gitKinsey/Operation-SafeFlight/development code/preparations/Module Tests/multiple Hc-sro4 with newPing/versuchsaufbau.jpg

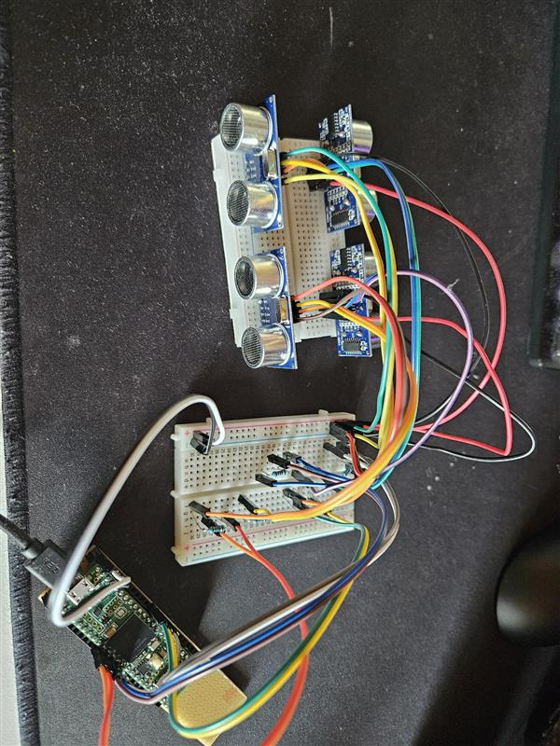
development code/preparations/Module Tests/multiple Hc-sro4 with newPing/versuchsaufbau.jpg
