gitKinsey/Operation-SafeFlight/development code/main/code parts/Avoiding codes/Height_Control_V3/Height_Control_V3.ino

#include <Arduino.h>
#include <Wire.h>
#include "Adafruit_VL53L0X.h"

// tof sensor setup
Adafruit_VL53L0X lox;  // just a name for the VL53lox sensor
float MeasurementTof = 4000;

// ppm Setup
#define PPM_PIN 2

// PPM settings
#define PPM_OUT_PIN 6                  // Output pin for PPM signal (changed from 2 to 3 to avoid conflict with PPM_PIN)
#define NUM_CHANNELS 8                 // Number of PPM channels
#define PPM_PERIOD 20000               // Total PPM frame length in microseconds (20ms)
#define PULSE_LENGTH 300               // Length of sync pulse in microseconds
#define MIN_CHANNEL_PULSE 1000         // Minimum channel pulse length in microseconds
#define MAX_CHANNEL_PULSE 2000         // Maximum channel pulse length in microseconds
uint16_t channelValues[NUM_CHANNELS];  // Create an array that holds uint16_t with all the channel values

// variables for ppm (here just the channel variables)
volatile uint16_t channel1 = 1500;  // uint16_t = int with 2^16 different values, initialize to 1500us
volatile uint16_t channel2 = 1500;
volatile uint16_t channel3 = 1500;
volatile uint16_t channel4 = 1000;
volatile uint16_t channel5;
volatile uint16_t channel6;
volatile uint16_t channel7;
volatile uint16_t channel8;
volatile uint8_t currentChannel = 0;  // Volatile: value can change at any time without action being taken, uint8_T: stores values between 0 and 255 (only integers)

// define the functions, needs to be done in order to use PlatformIo
void readPPM();
void sendPPM();
int mapValuesToHeightControl(int input);

void setup() {
  Serial.begin(9600);  // Start serial communication for debugging
  Serial.println("Start of program");
  pinMode(PPM_PIN, INPUT_PULLUP);                                     // Enable internal pull-up resistor
  attachInterrupt(digitalPinToInterrupt(PPM_PIN), readPPM, FALLING);  // Set up an interrupt on PPM_PIN

  pinMode(PPM_OUT_PIN, OUTPUT);
  digitalWrite(PPM_OUT_PIN, HIGH);

  // tof Setup:
  Wire.begin();

  if (!lox.begin()) {
    Serial.println("Failed to boot VL53L0X sensor");
  } else {
    // Set up the sensor for continuous measurement
    lox.setMeasurementTimingBudgetMicroSeconds(18000);  // Set timing budget to 18ms
    lox.startRangeContinuous();  // Start continuous measurements
  }
}

void loop() {
<<<<<<< HEAD:main/code parts/Avoiding codes/Height_Control_V3/Height_Control_V3.ino
  // put your main code here, to run repeatedly:
  if (channel6 < 1600) {
    doMeasurementTOF();
    int heightAdjustment = mapValuesToHeightControl(MeasurementTof);
    noInterrupts();
    channelValues[0] = channel1;
    channelValues[1] = channel2;
    channelValues[2] = channel3;
    channelValues[3] = channel4 + heightAdjustment;
    channelValues[4] = channel5;
    channelValues[5] = channel6;
    channelValues[6] = channel7;
    channelValues[7] = channel8;
    interrupts();

    sendPPM();
    delay(20);
  }

  else {
    //do the normal signal part
    noInterrupts();
    channelValues[0] = channel1;
    channelValues[1] = channel2;
    channelValues[2] = channel3;
    channelValues[3] = channel4;
    channelValues[4] = channel5;
    channelValues[5] = channel6;
    channelValues[6] = channel7;
    channelValues[7] = channel8;
    interrupts();

    //sending out the ppm signals again, with or without the adjustments to channel 4
    sendPPM();
  }
=======
  noInterrupts();
  channelValues[0] = channel1;
  channelValues[1] = channel2;
  channelValues[2] = channel3;
  channelValues[3] = channel4;
  channelValues[4] = channel5;
  channelValues[5] = channel6;
  channelValues[6] = channel7;
  channelValues[7] = channel8;
  interrupts();

  if (channel6 < 1600) {
    // Read the latest distance measurement in continuous mode
    MeasurementTof = lox.readRange();

    // Check if the measurement is valid
    if (!lox.timeoutOccurred()) {
      int heightAdjustment = mapValuesToHeightControl(MeasurementTof);
      noInterrupts();
      channel4 += heightAdjustment;
      channelValues[3] = channel4;
      interrupts();
    } else {
      // Handle timeout or invalid measurement
      Serial.println("Measurement timeout occurred");
    }
  }
  
  // Sending out the ppm signals again, with or without the adjustments to channel 4
  sendPPM();
>>>>>>> 0a8cb553f1f0b477e261b3234b402f1ea484bc94:development code/main/code parts/Avoiding codes/Height_Control_V3/Height_Control_V3.ino
}

void sendPPM() {
  uint32_t frameStartTime = micros();
  uint32_t lastPulseEndTime = frameStartTime;

  for (uint8_t i = 0; i < NUM_CHANNELS; i++) {
    // Calculate the exact time to wait before the next pulse
    uint32_t pulseStartTime = lastPulseEndTime + (channelValues[i] - PULSE_LENGTH);

    // Wait for the time to send the next pulse
    while (micros() < pulseStartTime) {
      // Busy wait
    }

    // Send the channel pulse
    Serial.print("Sending pulse for channel ");
    Serial.print(i + 1);
    Serial.print(" with length ");
    Serial.print(channelValues[i]);
    Serial.println(" us");

    digitalWrite(PPM_OUT_PIN, HIGH);
    delayMicroseconds(PULSE_LENGTH);
    digitalWrite(PPM_OUT_PIN, LOW);

    // Update the last pulse end time
    lastPulseEndTime = pulseStartTime + PULSE_LENGTH;
  }

  // Calculate remaining time for the sync pulse
  uint32_t timeSpent = micros() - frameStartTime;
  uint32_t syncPulseLength = PPM_PERIOD - timeSpent;

  // Ensure sync pulse length is at least the pulse length
  if (syncPulseLength > PULSE_LENGTH) {
    delayMicroseconds(syncPulseLength - PULSE_LENGTH);
  }

  // Send the sync pulse
  Serial.println("Sending sync pulse");
  digitalWrite(PPM_OUT_PIN, HIGH);
  delayMicroseconds(PULSE_LENGTH);
  digitalWrite(PPM_OUT_PIN, LOW);
}

void readPPM() {
  static uint32_t lastTime = 0;                // Variable to store the time of the previous pulse
  uint32_t currentTime = micros();             // Get the current time in microseconds
  uint32_t interval = currentTime - lastTime;  // Calculate the time interval since the last pulse
  lastTime = currentTime;                      // Update lastTime to the current time for the next interval calculation

  if (interval >= 3000) {  // Check if the interval is 3000 microseconds or more
    // A sync pulse is detected (interval longer than 3 milliseconds)
    // This sync pulse indicates the start of a new frame period
    currentChannel = 0;  // Reset to the first channel
  } else {
    // If the interval is less than 3000 microseconds, process the pulse for the current channel
    switch (currentChannel) {
      case 0:
        channel1 = interval;
        break;
      case 1:
        channel2 = interval;
        break;
      case 2:
        channel3 = interval;
        break;
      case 3:
        channel4 = interval;
        break;
      case 4:
        channel5 = interval;
        break;
      case 5:
        channel6 = interval;
        break;
      case 6:
        channel7 = interval;
        break;
      case 7:
        channel8 = interval;
        break;
    }
    currentChannel++;  // Move to the next channel
  }
}

// A function to map different incoming values from the tof sensor to the channel4 value, means closer distances = greater adjustment
int mapValuesToHeightControl(int input) {
  if (input <= 1000) {
    return map(input, 0, 999, 150, 0);
  } else {
    return 0;
  }
}
