gitKinsey/Operation-SafeFlight/(commit log)

2024-02-25 fist test of the ultrasonic sensor
    added the folder for the module tests and started with the ultrasonic sensor, for which I wrote a simple script to measure the distance (with the intention to see how much the measurements are affected by air currents around the drone)
2024-03-02 added a function just for tof
    in the file where both get tested, was added a function to just read out the tof sensor (with how long it takes)
2024-05-28 created, files for hc-sro4 and tof
    created, files for hc-sro4 and tof (made the neccessary functions etc. for the read out of the sensors)
    Plus combined everything sofar into the main file (which should work theoretically, needs to be tested)
2024-05-28 fixed ppm sender reader
    won't work bc of the timerONe library
    [main.cpp]
2024-05-29 change in librarys
    needed to change the newping library didn't work on teensy 4.1
    => back to completly standart without librarys for hc-sro4
    [main.cpp]
2024-06-04 changed Hc-sro4 code
    replaced the new ping stuff with completly standart code (no librarys)
    => hc-sro4 readouts happend without any library bc newPing doesn't work on Teensy 4.1
    [main.cpp]
2024-06-04 switched back to newPing
    thy to mjs513 (on github) for addapting the newPing library for teensy 4.x
    Plus i tested the new library with the newPing.io file under module test (with image :))
2024-06-04 some clean ups
    tested a few things (the pins do work (the hc-sro4 ones))
    - added some extra comments
    - got permission to use the adapted newPing version
    - clean up abit
    - put the sending part of ppm in a seperate function
    - some performance improvements (deletet unneccesary variable calls and stuff like that)
    - fixed an error with calling the newPing sensors, just in the declaration replace the int stuff with the stuff thats currently there)
    [main.cpp, newPing.ino]
2024-06-10 small things (clean up)
    cleaned up the setup in the main code
    - put everything that was possible into functions that get called
    => more readable
    createt a test file for the mpu6050 gyroscope module
2024-06-23 important update (sending ppm)
    created a whole new function to create the ppm function, bc the old one didn' t work as intended (look at file sender_and_receiver_v2_functional, im the code parts folder)
    Now decided i'mma stick to the teensy 4.1 microconroller
    updated the main file, screw main_v2 (with the multicore) and added the new implimation of the sender part into the file
2024-06-25 added mpu to code
    added basic implementation of mpu code to the main file, its tested should be working alright, rn it just reads out the values for acceleromation and angle and stores it
    will be used for leveling the drone before taking any actions yk
2024-06-27 first implementation of avoiding
    added a script to try to controll the height
    [HeightControll.ino, main.cpp]
2024-07-03 first implementation of the avoidance system
    added the first try to make the drone avoid stuff
    [main.cpp, sender_and_receiver.ino]
2024-10-11 new approach
    Now added a second microcontroller and they split the work, should get rid of the problem with the latency (saddly can't be mentioned in the written part)
    the microncontrollrs now communicate via rx and tx pins aka uart. The esp32 uses both of its cores one to read out sensordata the other one to send uart data.
    [esp32_code.ino, main.cpp, teensy_code.ino]
2024-10-11 error handeling
    Added a system to verify that the send packets are complet before useage, implementet a system to send "encrypted" packates that are labeld and some minor bug fixes
    [main.cpp]
